diegoleonardoro/dial-firmware/docs/breadboard_map.png

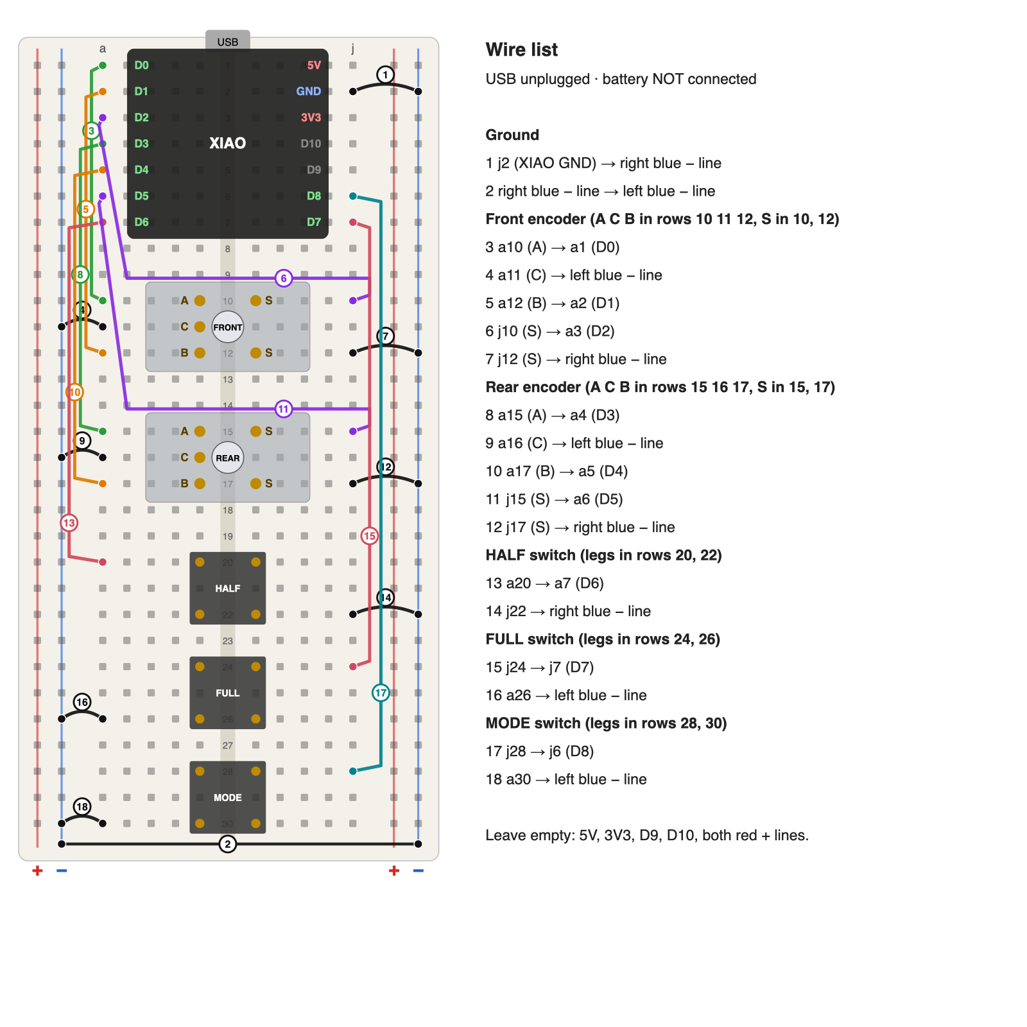
docs/breadboard_map.png
