diegoleonardoro/dial-firmware/(commit log)

2026-10-05 Firmware 0.1.0: protocol, encoders, buttons, BLE, battery, power
2026-10-11 Add breadboard layout, /resume command, serial wait for testing
    - BREADBOARD.md + docs/breadboard_map.png: hole-by-hole wiring for the
    400-point breadboard (README B2 points to it)
    - dial_config.h: DEBUG_WAIT_FOR_SERIAL_MS 3000 so boot lines show in the
    Serial Monitor during breadboard testing (set back to 0 before battery tests)
    - CLAUDE.md: "Where we left off" tracking, working notes
    - .claude/commands: new /resume, /checkpoint keeps "Where we left off"
